jsan82/Nixie-clock/nixie clock/nixie clock.kicad_pcb

## KiCad design nixie clock/nixie clock.kicad_pcb (2024-12-18)

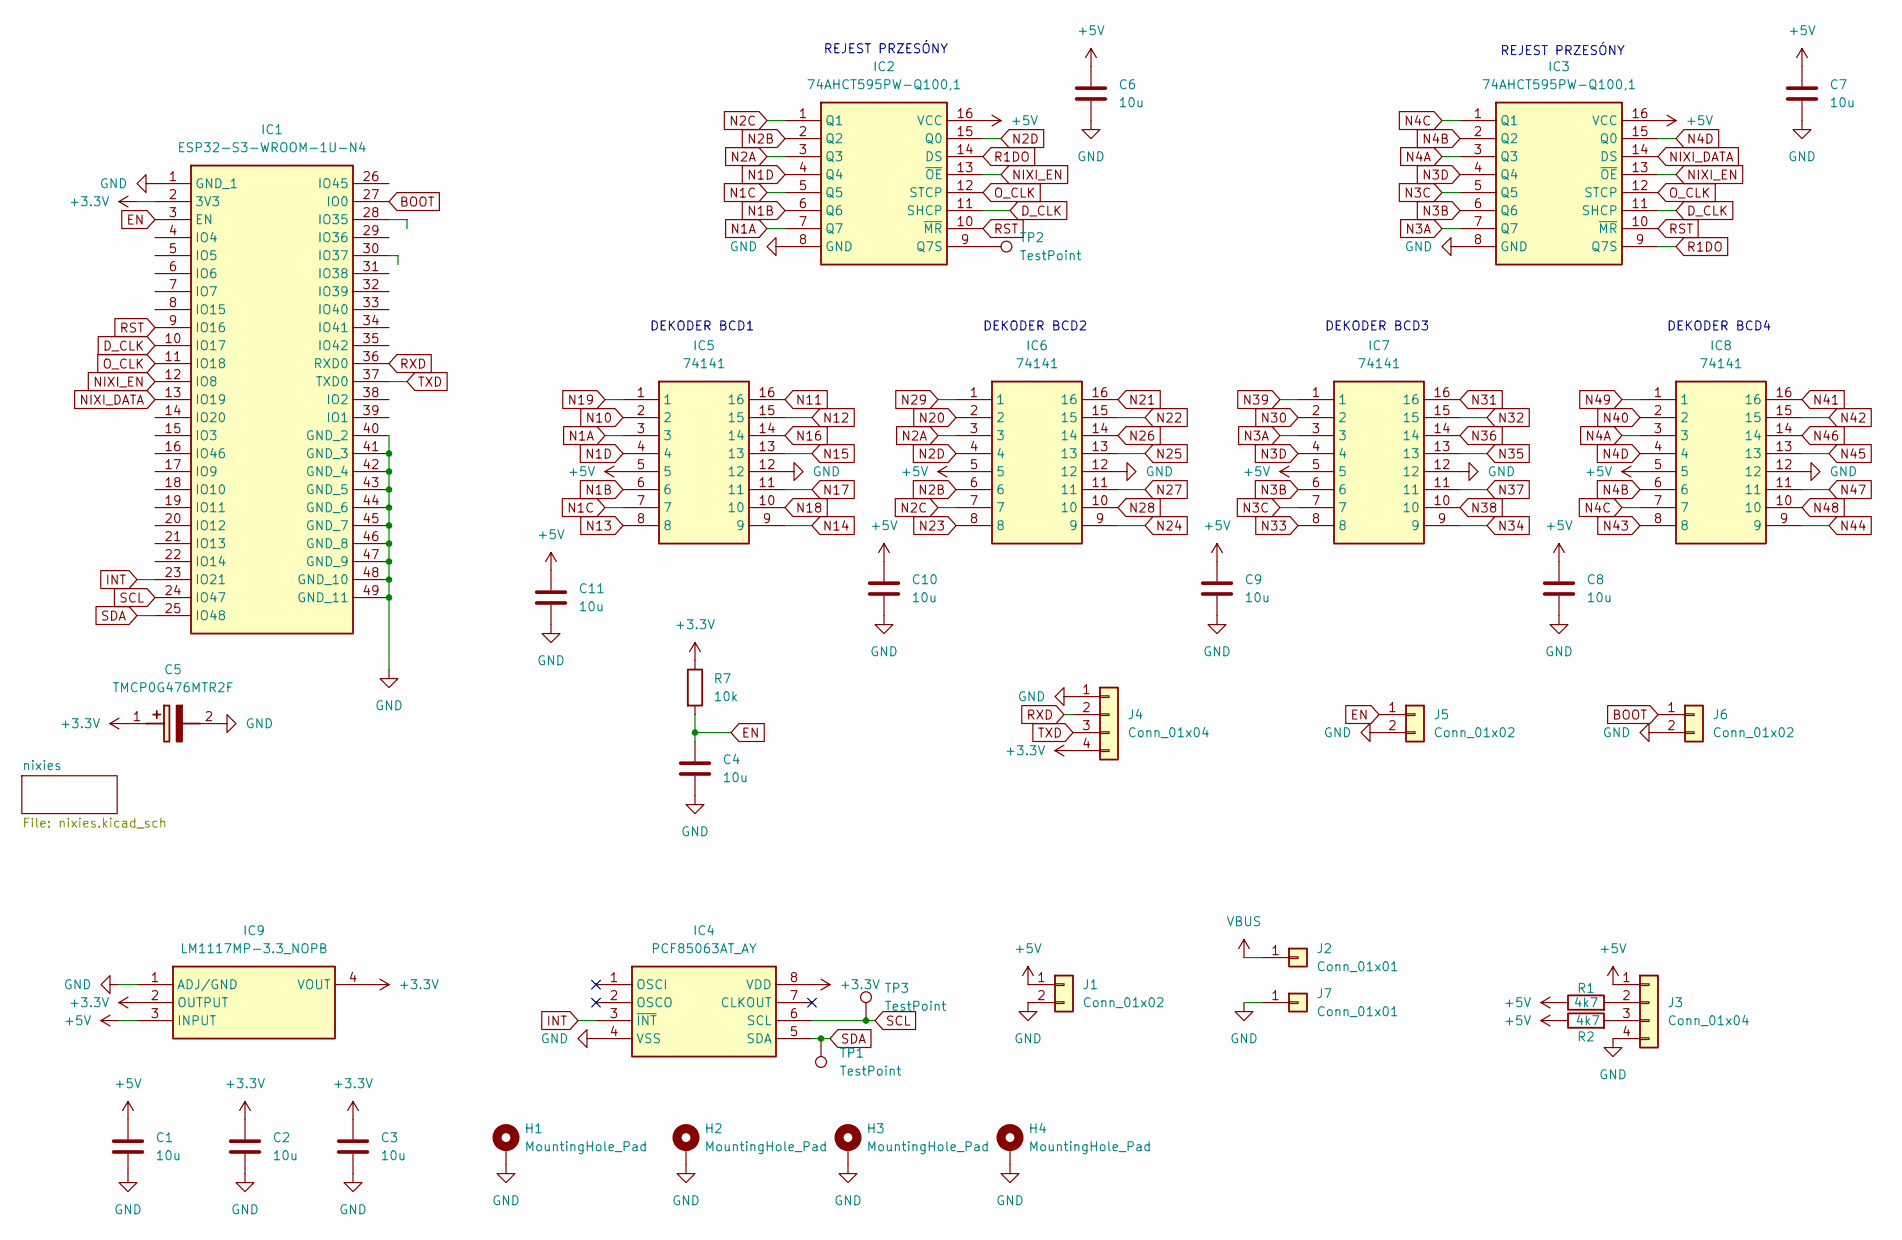
[picture p1: schematic nixie clock.kicad_sch]

Parts:
C1, C2, C3, C4, C6, C7, C8, C9, C10, C11: 10u; C_0805_2012Metric_Pad1.18x1.45mm_HandSolder
C5: TMCP0G476MTR2F; CAPPM2012X120N; Manufacturer_Part_Number TMCP0G476MTR2F; Mouser Part Number 74-TMCP0G476MTR2F
H1, H2, H3, H4: MountingHole_Pad; MountingHole_3.2mm_M3_Pad_Via
IC1: ESP32-S3-WROOM-1U-N4; ESP32S3WROOM1UN4; Manufacturer_Part_Number ESP32-S3-WROOM-1U-N4; Mouser Part Number 356-ESP32S3WROOM1UN4
IC2, IC3: 74AHCT595PW-Q100,1; SOP65P640X110-16N; Manufacturer_Part_Number 74AHCT595PW-Q100,1; Mouser Part Number 771-74AHCT595PWQ1001
IC4: PCF85063AT_AY; SOIC127P600X175-8N; Manufacturer_Part_Number PCF85063AT/AY; Mouser Part Number 771-PCF85063AT/AY
IC5, IC6, IC7, IC8: 74141; DIPS762W70P254L2032H510Q16N; Manufacturer_Part_Number 1-2199298-4; Mouser Part Number 571-1-2199298-4
IC9: LM1117MP-3.3_NOPB; SOT230P700X180-4N; Manufacturer_Part_Number LM1117MP-3.3/NOPB; Mouser Part Number 926-LM1117MP-3.3NOPB
J1, J5, J6: Conn_01x02; PinHeader_1x02_P2.54mm_Vertical
J2, J7: Conn_01x01; PinHeader_1x01_P2.54mm_Vertical
J3, J4: Conn_01x04; PinHeader_1x04_P2.54mm_Vertical
R1, R2: 4k7; R_0805_2012Metric_Pad1.20x1.40mm_HandSolder
R7: 10k; R_0805_2012Metric_Pad1.20x1.40mm_HandSolder
TP1, TP2, TP3: TestPoint

Connections:
+3.3V: C2.2, C3.2, C5.1 (+), IC1.2 (3V3), IC4.8 (VDD), IC9.2 (OUTPUT), IC9.4 (VOUT), J4.4, R7.1
+5V: C1.2, C6.2, C7.2, C8.2, C9.2, C10.2, C11.2, IC2.16 (VCC), IC3.16 (VCC), IC5.5, IC6.5, IC7.5, IC8.5, IC9.3 (INPUT), J1.1, J3.1, R1.1, R2.1
BOOT: IC1.27 (IO0), J6.1
D_CLK: IC1.10 (IO17), IC2.11 (SHCP), IC3.11 (SHCP)
EN: C4.1, IC1.3 (EN), J5.1, R7.2
GND: C1.1, C2.1, C3.1, C4.2, C5.2 (-), C6.1, C7.1, C8.1, C9.1, C10.1, C11.1, H1.1, H2.1, H3.1, H4.1, IC1.1 (GND_1), IC1.40 (GND_2), IC1.41 (GND_3), IC1.42 (GND_4), IC1.43 (GND_5), IC1.44 (GND_6), IC1.45 (GND_7), IC1.46 (GND_8), IC1.47 (GND_9), IC1.48 (GND_10), IC1.49 (GND_11), IC2.8 (GND), IC3.8 (GND), IC4.4 (VSS), IC5.12, IC6.12, IC7.12, IC8.12, IC9.1 (ADJ/GND), J1.2, J3.4, J4.1, J5.2, J6.2, J7.1
INT: IC1.23 (IO21), IC4.3 (~INT)
N1A: IC2.7 (Q7), IC5.3
N1B: IC2.6 (Q6), IC5.6
N1C: IC2.5 (Q5), IC5.7
N1D: IC2.4 (Q4), IC5.4
N2A: IC2.3 (Q3), IC6.3
N2B: IC2.2 (Q2), IC6.6
N2C: IC2.1 (Q1), IC6.7
N2D: IC2.15 (Q0), IC6.4
N3A: IC3.7 (Q7), IC7.3
N3B: IC3.6 (Q6), IC7.6
N3C: IC3.5 (Q5), IC7.7
N3D: IC3.4 (Q4), IC7.4
N4A: IC3.3 (Q3), IC8.3
N4B: IC3.2 (Q2), IC8.6
N4C: IC3.1 (Q1), IC8.7
N4D: IC3.15 (Q0), IC8.4
N10: IC5.2; also elsewhere on the board
N11: IC5.16; also elsewhere on the board
N12: IC5.15; also elsewhere on the board
N13: IC5.8; also elsewhere on the board
N14: IC5.9; also elsewhere on the board
N15: IC5.13; also elsewhere on the board
N16: IC5.14; also elsewhere on the board
N17: IC5.11; also elsewhere on the board
N18: IC5.10; also elsewhere on the board
N19: IC5.1; also elsewhere on the board
N20: IC6.2; also elsewhere on the board
N21: IC6.16; also elsewhere on the board
N22: IC6.15; also elsewhere on the board
N23: IC6.8; also elsewhere on the board
N24: IC6.9; also elsewhere on the board
N25: IC6.13; also elsewhere on the board
N26: IC6.14; also elsewhere on the board
N27: IC6.11; also elsewhere on the board
N28: IC6.10; also elsewhere on the board
N29: IC6.1; also elsewhere on the board
N30: IC7.2; also elsewhere on the board
N31: IC7.16; also elsewhere on the board
N32: IC7.15; also elsewhere on the board
N33: IC7.8; also elsewhere on the board
N34: IC7.9; also elsewhere on the board
N35: IC7.13; also elsewhere on the board
N36: IC7.14; also elsewhere on the board
N37: IC7.11; also elsewhere on the board
N38: IC7.10; also elsewhere on the board
N39: IC7.1; also elsewhere on the board
N40: IC8.2; also elsewhere on the board
N41: IC8.16; also elsewhere on the board
N42: IC8.15; also elsewhere on the board
N43: IC8.8; also elsewhere on the board
N44: IC8.9; also elsewhere on the board
N45: IC8.13; also elsewhere on the board
N46: IC8.14; also elsewhere on the board
N47: IC8.11; also elsewhere on the board
N48: IC8.10; also elsewhere on the board
N49: IC8.1; also elsewhere on the board
NIXI_DATA: IC1.13 (IO19), IC3.14 (DS)
NIXI_EN: IC1.12 (IO8), IC2.13 (~OE), IC3.13 (~OE)
unnamed: IC2.9 (Q7S), TP2.1
unnamed: J3.2, R1.2
unnamed: J3.3, R2.2
O_CLK: IC1.11 (IO18), IC2.12 (STCP), IC3.12 (STCP)
R1DO: IC2.14 (DS), IC3.9 (Q7S)
RST: IC1.9 (IO16), IC2.10 (~MR), IC3.10 (~MR)
RXD: IC1.36 (RXD0), J4.2
SCL: IC1.24 (IO47), IC4.6 (SCL), TP3.1
SDA: IC1.25 (IO48), IC4.5 (SDA), TP1.1
TXD: IC1.37 (TXD0), J4.3
VBUS: J2.1; also elsewhere on the board

Notes on the sheet:
DEKODER BCD2
REJEST PRZESÓNY
DEKODER BCD4
DEKODER BCD3
DEKODER BCD1

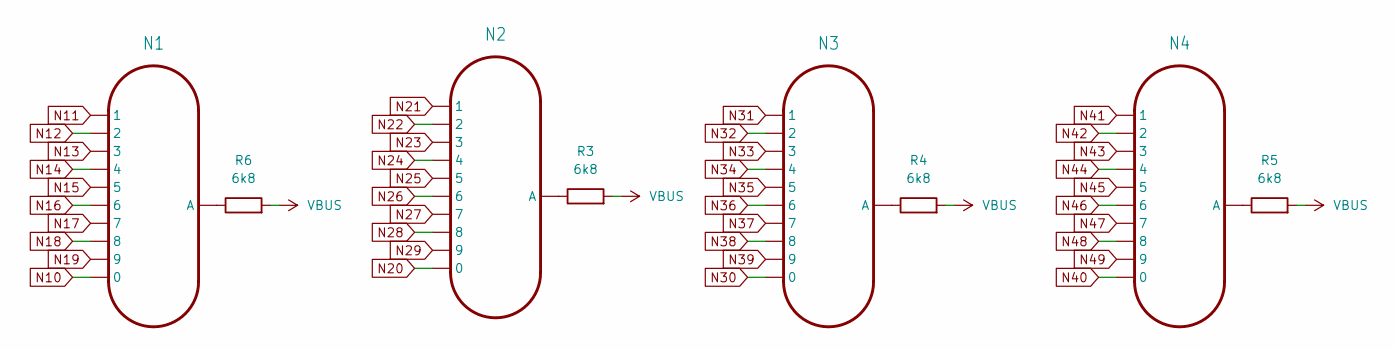
[picture p2: schematic nixies.kicad_sch]

Parts:
N1, N2, N3, N4: nixies-us-IN-4-DSUB
R3, R4, R5, R6: 6k8; R_Axial_DIN0207_L6.3mm_D2.5mm_P15.24mm_Horizontal

Connections:
N10: N1.0; also elsewhere on the board
N11: N1.1; also elsewhere on the board
N12: N1.2; also elsewhere on the board
N13: N1.3; also elsewhere on the board
N14: N1.4; also elsewhere on the board
N15: N1.5; also elsewhere on the board
N16: N1.6; also elsewhere on the board
N17: N1.7; also elsewhere on the board
N18: N1.8; also elsewhere on the board
N19: N1.9; also elsewhere on the board
N20: N2.0; also elsewhere on the board
N21: N2.1; also elsewhere on the board
N22: N2.2; also elsewhere on the board
N23: N2.3; also elsewhere on the board
N24: N2.4; also elsewhere on the board
N25: N2.5; also elsewhere on the board
N26: N2.6; also elsewhere on the board
N27: N2.7; also elsewhere on the board
N28: N2.8; also elsewhere on the board
N29: N2.9; also elsewhere on the board
N30: N3.0; also elsewhere on the board
N31: N3.1; also elsewhere on the board
N32: N3.2; also elsewhere on the board
N33: N3.3; also elsewhere on the board
N34: N3.4; also elsewhere on the board
N35: N3.5; also elsewhere on the board
N36: N3.6; also elsewhere on the board
N37: N3.7; also elsewhere on the board
N38: N3.8; also elsewhere on the board
N39: N3.9; also elsewhere on the board
N40: N4.0; also elsewhere on the board
N41: N4.1; also elsewhere on the board
N42: N4.2; also elsewhere on the board
N43: N4.3; also elsewhere on the board
N44: N4.4; also elsewhere on the board
N45: N4.5; also elsewhere on the board
N46: N4.6; also elsewhere on the board
N47: N4.7; also elsewhere on the board
N48: N4.8; also elsewhere on the board
N49: N4.9; also elsewhere on the board
unnamed: N1.A3 (A), R6.1
unnamed: N2.A3 (A), R3.1
unnamed: N3.A3 (A), R4.1
unnamed: N4.A3 (A), R5.1
VBUS: R3.2, R4.2, R5.2, R6.2; also elsewhere on the board

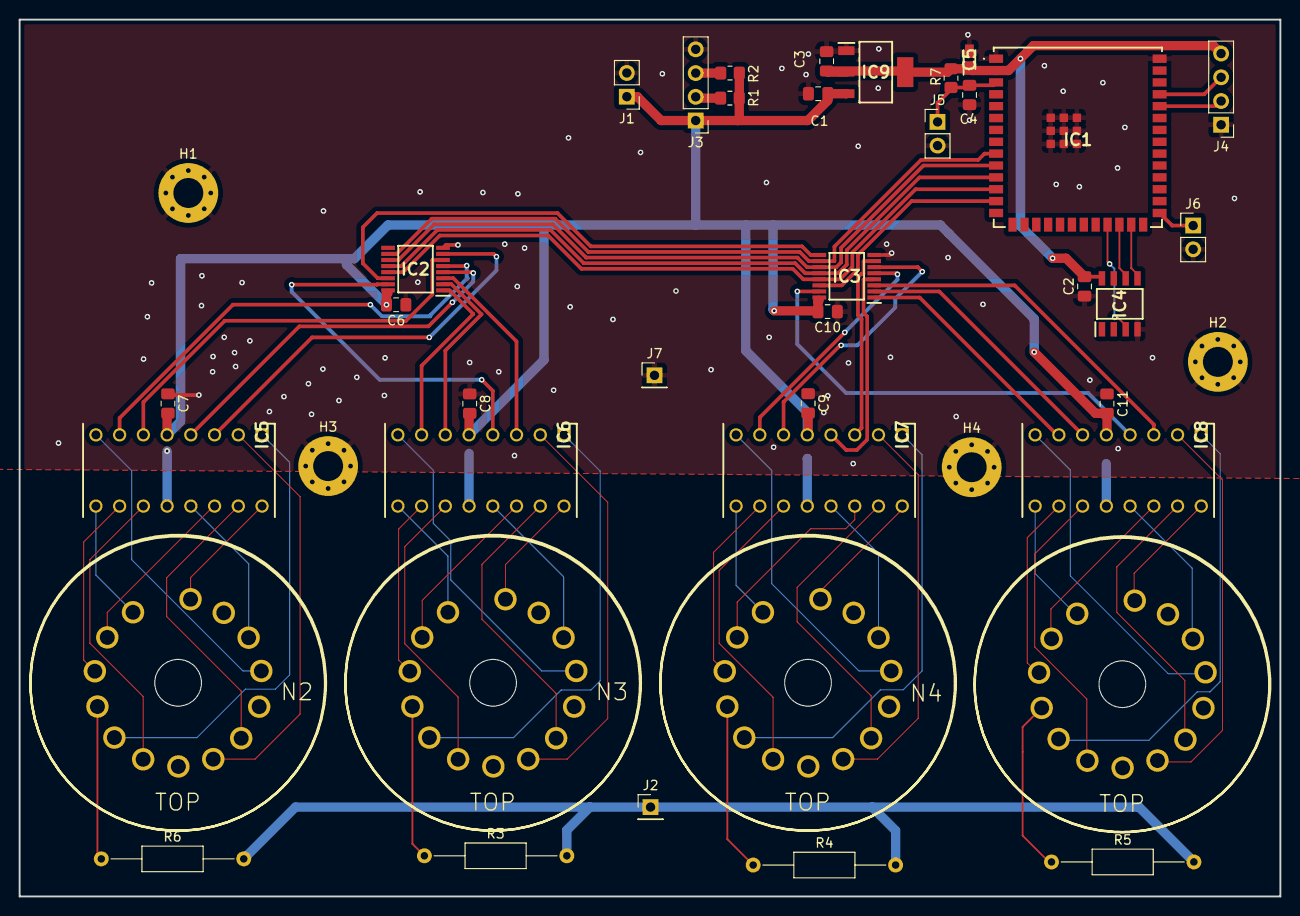
[picture p3: board nixie clock.kicad_pcb from above]

Board: 2 copper layers, 134.9 x 93.8 mm, 42 parts (0 on the bottom side), 79 nets.
