jsan82/Nixie-clock/(commit log)

2024-10-15 decoder and more
    [nixi clock.kicad_pcb, nixi clock.kicad_sch]
2024-11-09 nixi clock
    first pcb version
    [nixi clock.kicad_pcb, nixi clock.kicad_sch, nixies.kicad_sch]
2024-12-18 ESP32soft
    Program that connect to the internet and send hour to the nixie clock after some decoding because I messed up in kiCad and connect pins incorrectly
    [nixi clock.kicad_pcb]
